tentator/brachiograph-esp32-nfd/images/template-a4-back-shift3mm.pdf

-10 -5 0 5 10

-15

-10

-5

-165° 180° -150°

-135°

-120°

-105°

-90° 90°

105°

120°

135°

165° 150°

robot base

hole hole
shoulder axis

## ESP32 BrachioGraph template - back (printed +3 mm towards the holes)

Printed like the front, then turned round and put on the same two pins, behind the robot:

the shoulder angles behind the robot, for the precise calibration (-105°, -120° ...).

Print at 100 % (actual size): the bar below must measure exactly 10 cm.

Punch the two holes with an office 2-hole punch; the printed circles should sit on them (if they don't, see --shift-y in images/template.py). Grid: 1 cm in robot coordinates (X to the robot's right,

Y away from it). Red: shoulder angles from the shoulder axis. Made for 80 mm arms (L1 = L2 = 80 mm).

10 cm
