tentator/brachiograph-esp32-nfd/images/template-a4-front-shift3mm.pdf

10 | 5 | 0 | -5 | -10

5

10

15

default drawing area

-90°

-75°

-60°

-45°

-30° 30° | 15° | 0° | -15°

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
105°

120°

135°

150°

165°

elbow, shoulder at 0°

robot base

hole | hole

shoulder axis

## ESP32 BrachioGraph template - front (printed +3 mm towards the holes)

Lies in front of the robot, on its two pins. For drawing, Draw 1 cm Grid and the precise calibration. Blue: elbow angles with the shoulder at 0°, from the elbow (0, 8 cm).
Print at 100 % (actual size): the bar below must measure exactly 10 cm.
Punch the two holes with an office 2-hole punch; the printed circles should sit on them (if they
don't, see --shift-y in images/template.py). Grid: 1 cm in robot coordinates (X to the robot's right,
Y away from it). Red: shoulder angles from the shoulder axis. Made for 80 mm arms (L1 = L2 = 80 mm).

10 cm
