tentator/brachiograph-esp32-nfd/images/esp32-usb.jpg

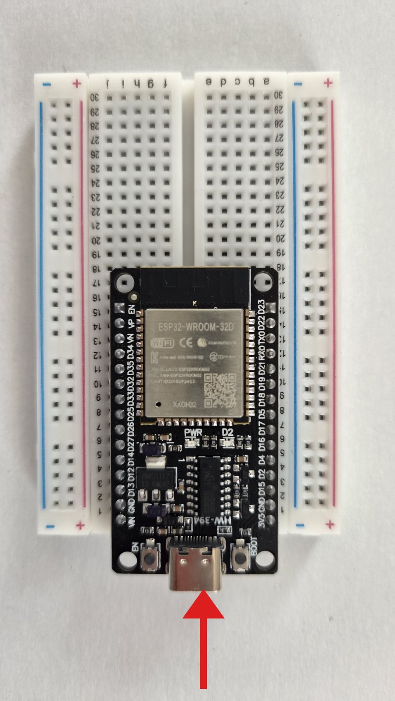
images/esp32-usb.jpg
