tentator/brachiograph-esp32-nfd/3d-prints/a4-bracket.stl

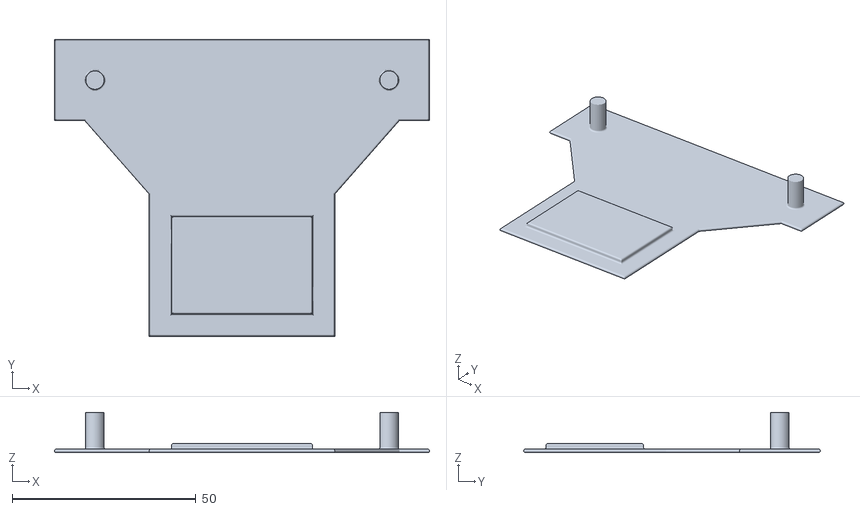
[picture p6: CAD file, 2026-11-11]
3d-prints/a4-bracket.stl
102.0 x 80.7 x 11.0
