tentator/brachiograph-esp32-nfd/3d-prints/upper-arm.stl

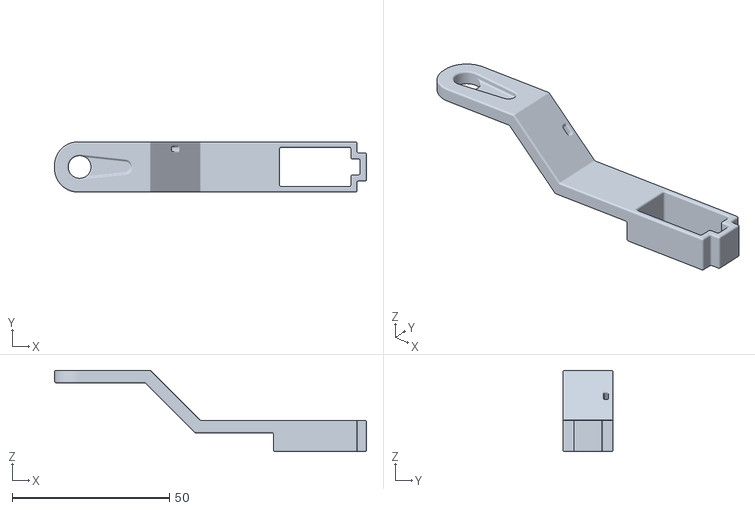
[picture p7: CAD file, 2026-11-11]
3d-prints/upper-arm.stl
99.2 x 16.0 x 25.9
