tentator/brachiograph-esp32-nfd/3d-prints/base.stl

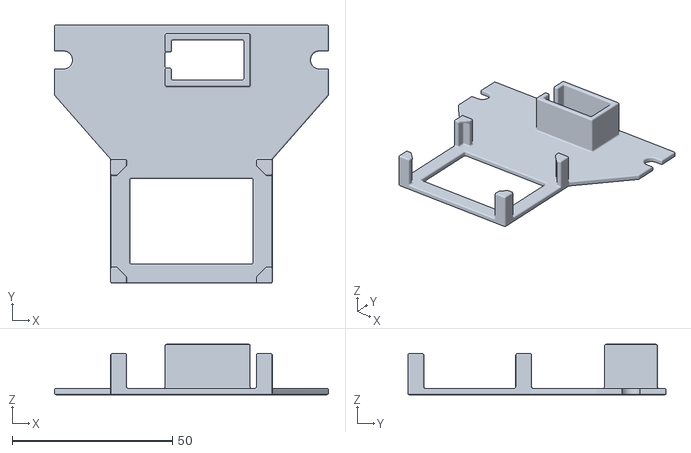
[picture p8: CAD file, 2026-11-11]
3d-prints/base.stl
85.6 x 80.7 x 15.8
