tentator/brachiograph-esp32-nfd/3d-prints/lower-arm.stl

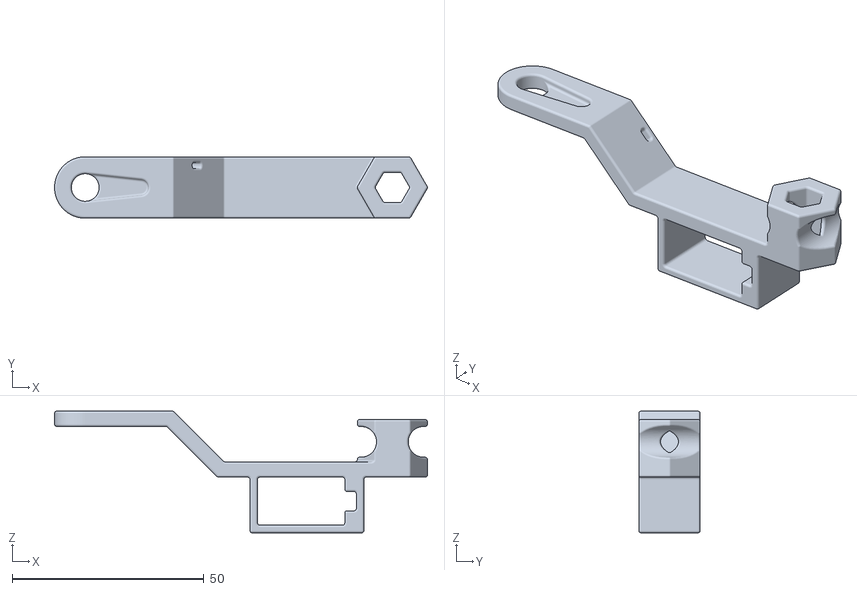
[picture p9: CAD file, 2026-11-10]
3d-prints/lower-arm.stl
97.1 x 16.0 x 31.7
