tentator/brachiograph-esp32-nfd/images/wiring_placeholder.png

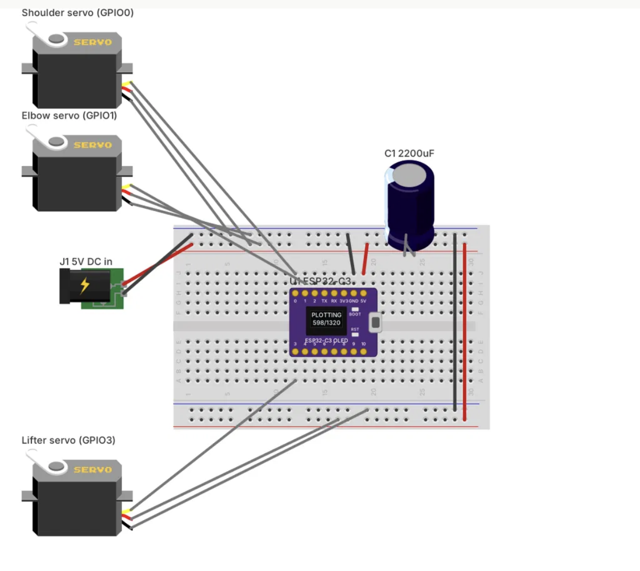
images/wiring_placeholder.png
