tentator/brachiograph-esp32-nfd/(commit log)

2026-10-29 initial commit of the esp32 porting of brachioraph from rpi, already working but web interface needs some more features
2026-11-08 Classic ESP32 DevKit pins, customization.json with Wi-Fi rejoin, updates over Wi-Fi, flash.sh
2026-11-08 Park pose at power-on and after every plot, ramped joint glide, elbow slope for 3D-printed arms
2026-11-08 Rescue server for failed updates, request timeouts, upload checks, immediate stop, quiet servos at boot and reset
2026-11-08 README for the ESP32-C3 OLED board: drawn flashing and wiring pictures with fixed wire colours, flash.sh detects the chip
2026-11-09 flash.sh finds the ESP32 on any ttyACM or ttyUSB port and takes short port names like ACM1
2026-11-09 flash.sh detects the ESP32-C3 reliably and stops when the given port is not plugged in instead of trying Wi-Fi
2026-11-09 Servos start one after another, flash.sh and the pin defaults support any ESP32 with Wi-Fi, servos powered from the board documented
2026-11-09 Chris Huang's ESP32-WROOM port: classic ESP32 pins 26/18/19, "oled": false skips the display and ssd1306, AP off after joining, WPA2 access point
2026-11-09 flash.sh shows ports, chip, files and log by USB and Wi-Fi and finds the board on its own AP, Wi-Fi failures on the OLED, steady fallback AP, customization.json checks
2026-11-09 REV 16: precompiled install, safer flash.sh, Wi-Fi fixes, board names, LED heartbeat
    Builds on the wifi-and-classic-esp32 branch (main/plotter/rescue split, joining a
    Wi-Fi via customization.json, updates over Wi-Fi with a rescue server, classic ESP32
    support, park pose, paper-side view, ramped glide).
    Memory
    - Install plotter, rescue and ssd1306 as precompiled .mpy files: about 65 KB of RAM
    instead of about 133 KB for the .py sources (REV 15 needed 88 KB, REV 11 failed at
    148 KB). requirements.txt adds mpy-cross 1.29.
    flash.sh (rewritten)
    - Finds the ESP32 by USB ID (Espressif USB, CP210x, CH340/CH9102, FTDI), skips other
    serial devices and asks if several remain.
    - Asks MicroPython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
2026-11-10 Targets out of the arms' reach are refused instead of swinging the arm to full right, one moving command at a time so a second one or a job start cannot fight it
2026-11-10 Classic ESP32 servo pins back to GPIO 25/26/27 as agreed with Chris Huang
2026-11-10 STLs exported again from the Onshape model: lower arm with reshaped pen lifter mount and new fillet, base and A4 bracket updated
2026-11-10 REV 17: optional precise calibration on the template, grid check, area warning
    Precise calibration (optional, section 8 of the page)
    - Measures each servo on the BrachioGraph template (template-grid.pdf): the page names
    a red line (shoulder) or blue line (elbow), you move the arm onto it with fine pulse
    buttons (+-1/5/20 us) and press Here. The measured points (s1_table, s2_table in
    config.json) replace Park/Slope; the board interpolates straight between them.
    - Optional: approach each line from both sides; the middle is saved and the average
    difference is set as the hysteresis correction (measured backlash).
    - Guards: Here refused at the servo limit and when a point doesn't continue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
2026-11-11 REV 18: works out of the box with the 3D-printed hardware: defaults in customization.defaults.json, board settings kept unless replaced, flash.sh without sudo (deploy_udev.sh), new wiring picture, ph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
2026-11-11 REV 18: settings and calibration in separate files with single defaults, quiet flash.sh, landscape templates
    Builds on PR #4 (assembly improvements: robot on landscape A4, wiring picture, photos,
    STLs, 3D-printed defaults, deploy_udev.sh, 13 dBm on every C3).
    Settings
    - Board settings (name, Wi-Fi, passwords, access point, transmit power, pins, LED,
    display): defaults in board_default_settings.json, yours in board_settings.json next
    to flash.sh (not in git). Values that differ by chip are maps {"*": ..., "ESP32C3": ...}.
    - Calibration: defaults in board_default_calibration.json, this board's own in
    board_calibration.json on the board only (Apply Config / precise calibration), saved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
